antono/tk44-case/tk44-case.FCStd

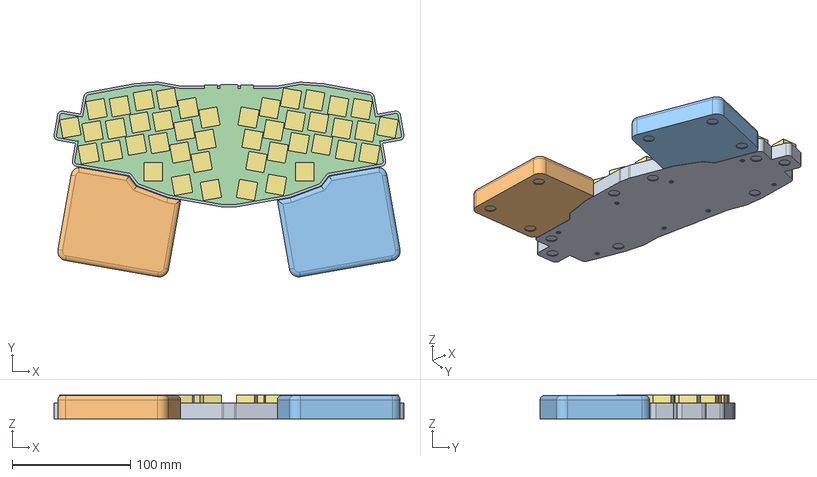
[picture p3: CAD file, 2026-10-12]
tk44-case.FCStd
295.9 x 164.7 x 20.2 mm
Tray
WristRestL
WristRestR
TrayVaseFit
ref_PCB
ref_Plate
ref_Switches
